HarryPehkonen/xiao-ac-dimmer/BOM.md

# BOM — one board

Generated from the schematic, not typed from memory:

```bash
kicad-cli sch export bom --fields "Reference,Value,Footprint" \
  -o bom.csv xiao-ac-dimmer.kicad_sch
```

20 parts. `bom.csv` is the source of truth for values and footprints; this file
adds the part of the BOM a generator cannot know: **where to buy it, and what it
costs to get it here.**

## The sourcing rule

> **Consolidate to the fewest orders first. Origin is a tiebreaker on price, not
> an absolute.** A US-origin part that saves a shipment wins; a $6 saving that
> creates a second shipment loses.

Two constraints in tension, both Harri's:

1. **Non-US origin preferred** — US-origin parts carry tariff and political
   cost. DigiKey's Canadian presence is welcome as a *channel* (one shipment,
   CAD pricing, traceability), not as a statement about origin.
2. **Shipping is per-supplier and it is not small.** DigiKey CA: **free delivery
   at $100 CAD or more; about $15 CAD below that** (their delivery page states
   the $100 threshold; the sub-$100 charge has been reported rising to $15).

So a 20-line BOM can carry more shipping than parts. Two ways out: **pad the
order over $100** (spares of the passives are nearly free, and more boards are
coming), or **accept the charge once** rather than paying it several times.

## Where each part comes from

| Source | Parts |
| --- | --- |
| **DigiKey CA** (one order) | `C1` 470µF 16V · `C2` 100nF · `CS1` 100nF 400V · `D5` SS14 · `F1` 5×20mm fuseholder clip + 3.15A fuse · `MOV1` S14K150 · `Q1` BTA16-600B · `U1` H11AA1 · `U2` MOC3021M · `R1`,`R2` 47k · `R3` 220 · `R4` 1k · `R5` 10k · `RS1` 100 · `J1`,`J2` 1×07 pin sockets · `J3`,`J4` 5.08mm 2-pin terminal blocks |
| **AliExpress** | `PS1` HLK-PM01 5V 3W (about $1.79 CAD) |
| **Check the drawer first** | `U2` MOC3021M · `U1` H11AA1 · all resistors · 100nF / 470µF caps |

**Check the drawer first, seriously.** If the optos and the passives are already
in stock, the DigiKey order collapses to the awkward parts — terminals, fuse
holder, MOV, sockets — perhaps $25 of goods carrying $15 of shipping. That is
exactly the case where padding the order beats paying the charge.

### Why not the DigiKey alternative for PS1

Mean Well IRM-03-5 (`1866-3020-ND`) is the electrical equivalent (5V 3W 0.6A,
85–305 VAC in) and DigiKey stocks it, but: it is a **US-brand part at about
$8.17 CAD** after tariff, against $1.79; the swap costs **footprint change plus
rerouting PS1's pads and re-checking the 3mm barrier**; and the HLK-PM01's
footprint is already in the design. DigiKey publishes no Hi-Link parts at all —
their own TechForum cross-reference thread says they "cannot duplicate the
footprint shown on the HLK-PM01 data sheet" and names Recom RAC03-05SK
(`945-3441-ND`) as an electrically-correct substitute *with the wrong pin
layout*. KiCad has no RAC03 footprint; it does have the IRM-03 one.

**HLK-PM01 input range: 100–240 VAC, universal** — the manufacturer's own page
says "Rated input voltage 100-240Vac", and it is tested at 120 V and 230 V.
Listings titled "220V to 5V" are using the Chinese-market convention; it works
on North American 120 V mains. Max input current <0.2A.

### One spec to tighten

`CS1` is currently `100nF 400V`. For snubber duty across a mains triac, specify
the **part class**: an X2 or mains-duty film capacitor rated **250 VAC or
better**. "400 V" is a DC rating; it is not the same claim.

## The module (not on the PCB BOM)

The board has no MCU on it — it mounts a **Seeed Studio XIAO ESP32C3** in two 2×7
sockets (`J1`/`J2`), so the module never appears in the generated BOM. Order it
separately.

- **Part / SKU: `113991054`** (Seeed Studio; listed by Mouser under that same
  manufacturer number, category "Multiprotocol Modules").
- **Seeed direct** — seeedstudio.com, USD **$4.99**, in stock, sold 1pcs / 3pcs.
  Has China, US and German warehouses; **no Canadian warehouse**, so a Canadian
  order ships from China or the US.
- **Mouser Canada** (mouser.ca) lists the same number for CAD pricing.
- **DigiKey CA** returns 5 results for "XIAO ESP32C3" and hosts this part's
  datasheet, but its part number and stock **were not verified** — its result
  list would not render into text for me. Confirm on the page rather than
  trusting a `-ND` number written here.

**Order the Pre-Soldered variant.** `J1`/`J2` are female sockets, so the module
needs pins on it; Un-Soldered means hand-soldering 14 pins.

**Get the ESP32C3, not the ESP32S3 or C6.** They share the footprint and would
plug in, but the pin↔GPIO mapping differs, and this design assigns `D1`=GPIO3
(triac trigger) and `D2`=GPIO4 (zero-cross input). A different variant fits the
board and silently fires the wrong pins.

Two practical notes: 2.4 GHz does not pass through a metal enclosure, so use a
non-metallic box (or run the module's U.FL connector to an external antenna) —
and keep the antenna end away from `PS1` and the mains wiring. Flashing is over
USB-C; the `SS14` (`D5`) is there so USB 5 V and the PSU's 5 V can coexist
without one back-feeding the other.

## Mechanical — mounting

Four M3 clearance holes, one per corner, **5mm inset** from each board edge.
They are in the generated board, not a drawing note:

- **3.2mm drill**, non-plated (`MountingHole:MountingHole_3.2mm_M3`): no pad, no
  annular ring, connected to no net, so nothing is bonded and no copper sits
  under the screw head. They carry `exclude_from_bom` and
  `exclude_from_pos_files`, so they do not show up as parts to place.
- **6mm copper keepout** per hole — a 6mm-*diameter* copper-free disc, i.e. no
  track, via or pad edge within 3mm of the hole centre. A socket-head M3 screw
  is 5.5mm across, so the disc covers the head with a little margin. (Reading
  the spec the other way, a 6mm *radius*, puts the disc off the board: a 5mm
  inset hole would leave the outline.)
- **Nylon standoffs, not metal.** This is a two-wire appliance with no earth
  conductor, so there is nothing for a metal standoff or a metal enclosure to be
  safely bonded to. Plastic standoffs and a plastic box avoid the question
  entirely.
- Where it lives: `tools/gen_pcb.py` places them (`MOUNTING`, `MOUNT_INSET`,
  `MOUNT_DRILL`, `MOUNT_KEEPOUT`), `tools/route.py` enforces the keepout on both
  layers, and `tools/check_board.py` re-measures the finished board — inset,
  drill, NPTH, isolation and copper clearance — so a later re-route cannot
  quietly put copper back under a screw.
- The corner keepouts changed the corridors, and the holes' courtyards own the
  outer 3.45mm of each corner, so the packing strips start 9mm from the top
  instead of hugging the edge. The router still gets **16/16 nets** with 0 DRC
  errors and 0 warnings.

## Mechanical — board outline

**150 × 57mm (85.5cm²)**, down from 150 × 95mm (142.5cm²). The 20 parts span
41.9mm top to bottom (y 9 → 50.9mm), so the old 95mm left a **54mm dead band
along the bottom edge** — a third of the board. The height had been raised from
90mm to 95mm *while the router was failing*, and it stayed after the router was
fixed, because nothing measures the outline: it is an input to the pipeline, not
a result.

The height is now sized to the packed parts instead of chosen first (see
`BOARD_H` in `tools/gen_pcb.py`). 57mm keeps the 9mm the top mounting holes need
above the first row and leaves 6.1mm below the last — **15% spare on the bottom
side**, inside the 10-20% tolerance. The mounting holes are unaffected: still
5mm inset, 3.2mm NPTH, 6mm copper-free disc, which `check_board.py` re-measures
on the finished board at the new height.

## Mechanical — thermal

`Q1` (BTA16-600B) is the only real heat source. Its dissipation is the on-state
drop times load current, roughly 1.0–1.2 V at 1 A:

| Load | Dissipation | Verdict |
| --- | --- | --- |
| 60 W lamp (~0.5 A) | ~0.6 W | No heatsink. ~35 °C rise on a TO-220 in free air |
| 100 W lamp (~0.85 A) | ~1.0 W | Borderline. ~60 °C rise; a small clip-on heatsink is cheap insurance |
| Board ceiling, 3.15 A | ~3.5–4 W | **Real heatsink required.** ~5 °C/W, tab-mounted |

Notes that matter more than the table:

- **BTA (isolated tab), not BTB.** The `A` part's tab is electrically isolated,
  so a heatsink needs no insulating pad. Keep the heatsink **floating** —
  connected to no net.
- In an **enclosed box** the ambient is 40–50 °C, not 25 °C. Derate accordingly;
  the numbers above assume free air.
- `PS1`, the snubber, `MOV1` and the fuse are thermally irrelevant at this
  power level.
- Ventilation in the box is worth more than a bigger heatsink.
