HarryPehkonen/xiao-ac-dimmer/sim/results.txt

delay(ms) theta(deg)  sim Vrms   theory    err% watts/240R
      0.2        4.3    120.20   120.20    0.00       60.2
      0.5       10.8    120.12   120.12    0.00       60.1
      1.0       21.6    119.54   119.54    0.00       59.5
      1.5       32.4    118.02   118.03    0.00       58.0
      2.0       43.2    115.22   115.23    0.00       55.3
      2.5       54.0    110.91   110.92    0.00       51.3
      3.0       64.8    104.97   104.98    0.00       45.9
      4.0       86.4     88.33    88.33    0.00       32.5
      5.0      108.0     66.54    66.54    0.00       18.4
      6.0      129.6     42.27    42.27    0.00        7.4

worst disagreement vs closed form: 0.00%  (load 240.0 ohm resistive)
