HarryPehkonen/xiao-ac-dimmer/xiao-ac-dimmer.kicad_pcb

## KiCad design xiao-ac-dimmer.kicad_pcb (2026-11-03)

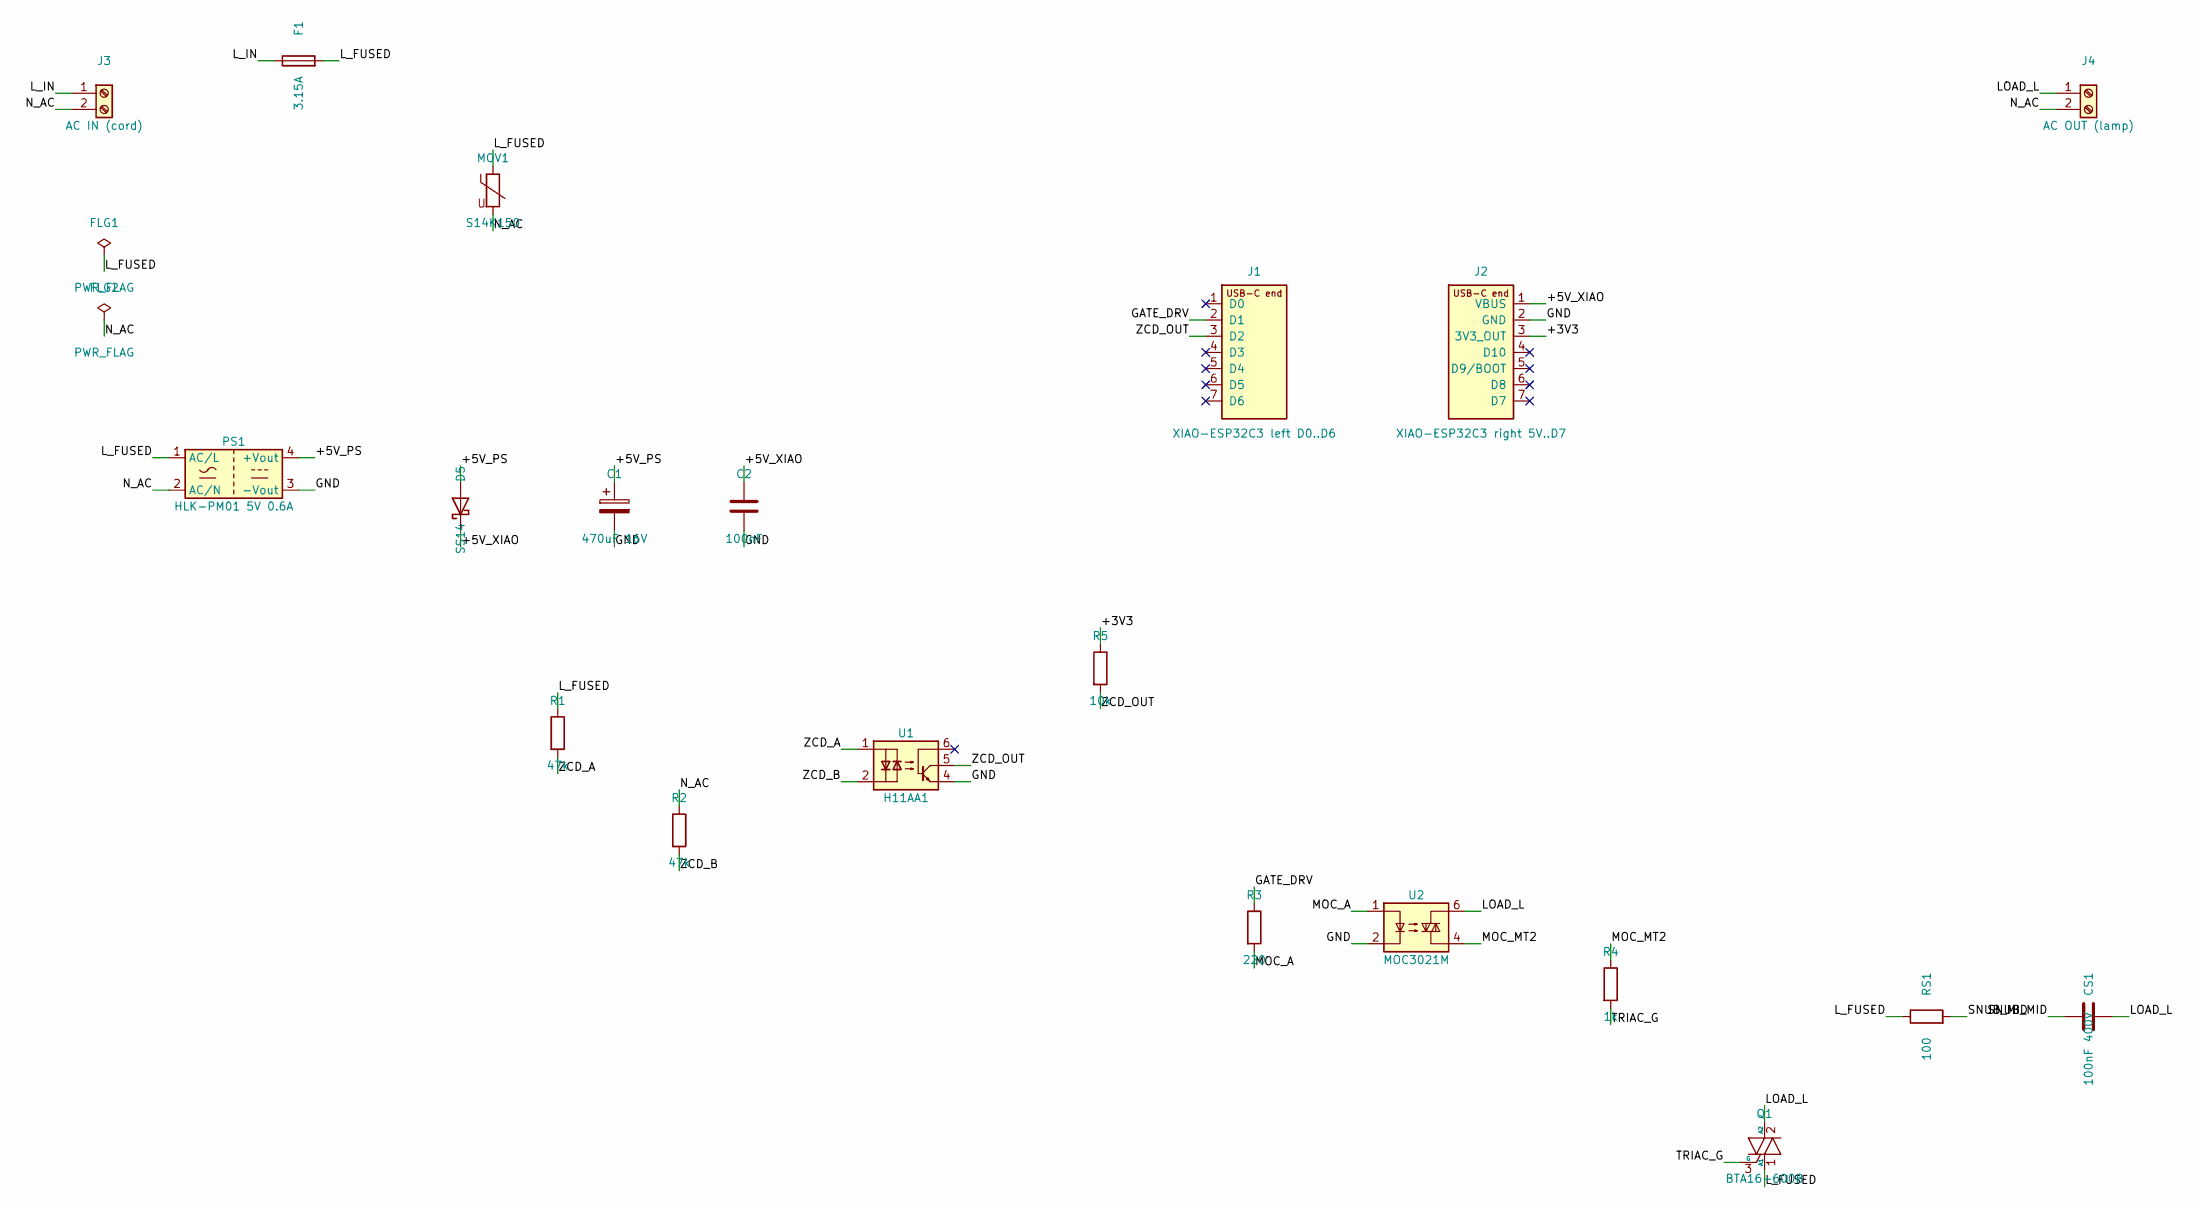
[picture p1: schematic xiao-ac-dimmer.kicad_sch, XIAO AC dimmer - 1 channel, inline cord]

Parts:
C1: 470uF 16V; CP_Radial_D8.0mm_P3.50mm
C2: 100nF; C_Disc_D5.0mm_W2.5mm_P5.00mm
CS1: 100nF 400V; C_Rect_L7.0mm_W2.0mm_P5.00mm
D5: SS14; D_DO-41_SOD81_P10.16mm_Horizontal
F1: 3.15A; Fuseholder_Clip-5x20mm_Keystone_3512P_Inline_P23.62x7.27mm_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
FLG1, FLG2: PWR_FLAG
J1: XIAO-ESP32C3 left D0..D6; PinSocket_1x07_P2.54mm_Vertical
J2: XIAO-ESP32C3 right 5V..D7; PinSocket_1x07_P2.54mm_Vertical
J3: AC IN (cord); TerminalBlock_Phoenix_MKDS-1,5-2-5.08_1x02_P5.08mm_Horizont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
J4: AC OUT (lamp); TerminalBlock_Phoenix_MKDS-1,5-2-5.08_1x02_P5.08mm_Horizont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
MOV1: S14K150; RV_Disc_D12mm_W4.5mm_P7.5mm
PS1: HLK-PM01 5V 0.6A; Converter_ACDC_Hi-Link_HLK-PMxx
Q1: BTA16-600B; TO-220-3_Vertical
R1, R2: 47k; R_Axial_DIN0207_L6.3mm_D2.5mm_P10.16mm_Horizontal
R3: 220; R_Axial_DIN0207_L6.3mm_D2.5mm_P10.16mm_Horizontal
R4: 1k; R_Axial_DIN0207_L6.3mm_D2.5mm_P10.16mm_Horizontal
R5: 10k; R_Axial_DIN0207_L6.3mm_D2.5mm_P10.16mm_Horizontal
RS1: 100; R_Axial_DIN0207_L6.3mm_D2.5mm_P10.16mm_Horizontal
U1: H11AA1; DIP-6_W7.62mm
U2: MOC3021M; DIP-6_W7.62mm

Connections:
+3V3: J2.3 (3V3_OUT), R5.1
+5V_PS: C1.1, D5.2 (A), PS1.4 (+Vout)
+5V_XIAO: C2.1, D5.1 (K), J2.1 (VBUS)
GATE_DRV: J1.2 (D1), R3.1
GND: C1.2, C2.2, J2.2 (GND), PS1.3 (-Vout), U1.4, U2.2
LOAD_L: CS1.2, J4.1, Q1.2 (A2), U2.6
L_FUSED: F1.2, FLG1.1, MOV1.1, PS1.1 (AC/L), Q1.1 (A1), R1.1, RS1.1
L_IN: F1.1, J3.1
MOC_A: R3.2, U2.1
MOC_MT2: R4.1, U2.4
N_AC: FLG2.1, J3.2, J4.2, MOV1.2, PS1.2 (AC/N), R2.1
SNUB_MID: CS1.1, RS1.2
TRIAC_G: Q1.3 (G), R4.2
ZCD_A: R1.2, U1.1
ZCD_B: R2.2, U1.2
ZCD_OUT: J1.3 (D2), R5.2, U1.5

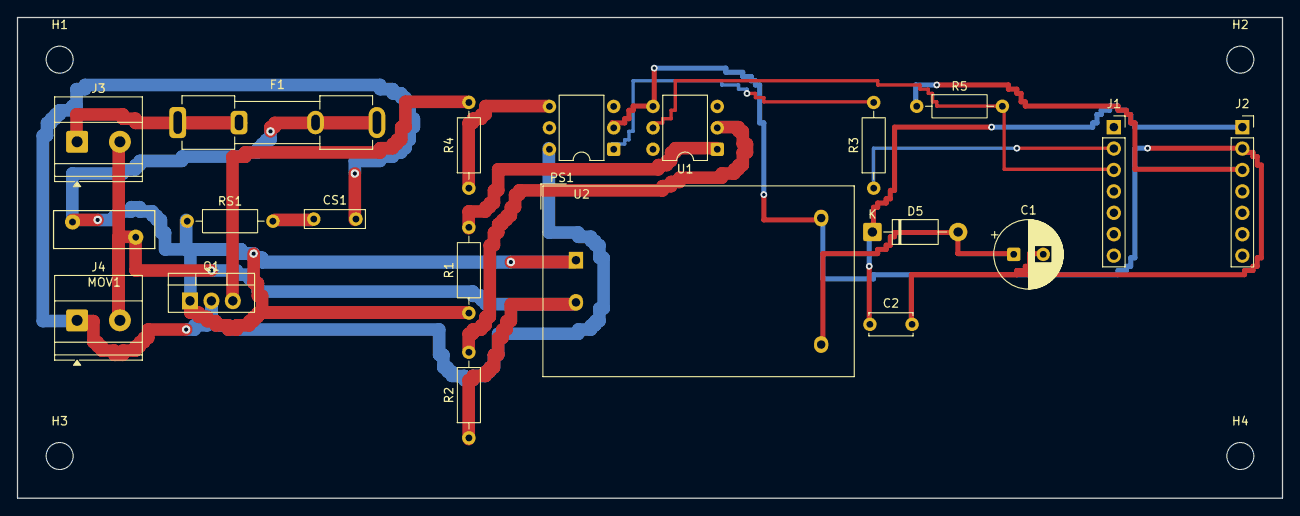
[picture p2: board xiao-ac-dimmer.kicad_pcb from above]

Board: 2 copper layers, 150.0 x 57.0 mm, 24 parts (0 on the bottom side), 16 nets.

Other parts of the board:
H1, H2, H3, H4: MountingHole_3.2mm_M3
