HarryPehkonen/xiao-ac-dimmer/(commit log)

2026-11-02 XIAO AC dimmer: generated schematic, netlist gate, ERC clean
    - tools/gen_sch.py builds xiao-ac-dimmer.kicad_sch from a parts/nets table
    (labelled stubs; no hand-drawn wires to drift out of sync)
    - tools/kicadlib.py: s-expression reader, symbol flattening for (extends)
    - tools/check_netlist.py gates the exported netlist against the intent --
    it caught a rotated-symbol pin swap that would have fitted D5 backwards
    - tools/ci.sh: regenerate check, netlist gate, ERC
    - sim/: leading-edge dimmer RMS vs closed form, 0.00% worst case
    - 1 channel, mains-fed HLK-PM01, MOC3021 + BTA16 phase control, H11AA1 ZCD
    - Unlicense
    [xiao-ac-dimmer.kicad_sch]
2026-11-02 gate: compare the schematic hash before regenerating
    The old check regenerated first, so it could never detect a stale committed
    schematic. Proven both ways: appending junk to the .kicad_sch now fails the
    gate, regenerating restores it.
2026-11-02 pcb: generated board, maze router, DRC barrier rule (3 nets unrouted)
    Nets come from the schematic netlist export so board and schematic cannot
    disagree. Placement is a zone packer (no courtyard overlaps by construction);
    routing is an A* maze router over a 0.5 mm grid with two occupancy grids so
    the 3 mm mains barrier does not fence the mains zone off from itself.
    The barrier is a kicad_dru rule, not a drawing note.
    DRC: no shorts, no clearance errors, 3 unconnected nets (TRIAC_G, MOC_MT2,
    MOC_A) and 4 hole_to_hole warnings from vias near pads. check_board.py is
    deliberately not wired into tools/ci.sh while it fails. See docs/PCB-NOTES.md.
    [xiao-ac-dimmer.kicad_pcb]
2026-11-02 pcb: 14/16 nets routed, DRC clean of shorts and clearance errors
    Diagnosis-driven routing fixes, each from a measured failure:
    - merge collinear grid steps: 2161 -> 410 segments
    - zone repack with the mains-side resistors in their own barrier strip; Q1
    last so its gate sits beside R4; U2 first so its logic pins face the logic
    cluster; wider board (150x95) for the barrier corridor
    - TRIAC_G and MOC_MT2 are mains-referenced (hot side of the opto) and were
    classed as logic, which made them demand 3 mm from the mains zone they live
    in; unroutable by construction. Fixed in the router and the kicad_dru rule.
    - route 2-pad nets before multi-pad power nets; escape spoke per pad
    perpendicul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
    [xiao-ac-dimmer.kicad_pcb]
2026-11-02 docs: ninny brief — red test first, explore in /tmp, run the acceptance command after every write
    Lessons from the first ninny run (see harrisbook posts 35 and 37): the
    delegate made nine writes and never ran the suite once, and left seven
    throwaway prototypes in tmp_diag/.
2026-11-03 BOM.md: sourcing rule, DigiKey CA shipping thresholds, mounting holes + thermal plan
    - Consolidation rule: fewest orders first, origin as a price tiebreaker.
    - DigiKey CA: free delivery at $100 CAD, ~$15 below it (their delivery page).
    - Why PS1 stays an HLK-PM01 from AliExpress, and why the IRM-03-5 swap is dead.
    - HLK-PM01 is universal input 100-240VAC despite '220V' listing titles.
    - CS1 should be specified as an X2/mains-duty film cap, 250VAC or better.
    - Mounting: no holes yet; 4x M3, 5mm inset, isolated pads, nylon standoffs.
    - Thermal: BTA16 dissipation table; no heatsink to 0.5A, real one at 3.15A.
2026-11-03 pcb: 16/16 nets routed, DRC clean of errors and warnings
    Bring the verified ninny pcb-2nets-r2 work into main: tools/route.py,
    tools/gen_pcb.py, tools/ci.sh, docs/PCB-NOTES.md, the two new test files and
    the regenerated board.
    Verified on this tree, not taken on trust: gen_pcb.py prints
    "routed 16/16 nets", check_board.py prints "0 error(s), 0 warning(s)",
    `pytest tools/tests/test_route_geometry.py` is 18 passed, and ./tools/ci.sh
    ends OK. The board carries 489 track segments and 15 vias, which is what
    docs/PCB-NOTES.md claims. The 3 mm barrier rule in xiao-ac-dimmer.kicad_dru and
    the net table are untouched.
    - route(): order nets by the static free-cell count of each net's tightest pad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
    [xiao-ac-dimmer.kicad_pcb]
2026-11-03 pcb: library nicknames, a nickname+keepout gate, and 4x M3 mounting holes
    Three changes in one regeneration pass, all of them in the generated board.
    1. Footprint library nicknames. FootprintLoad() returns the bare footprint name,
    so every footprint saved as (footprint "R_Axial_..." with no library link. The
    geometry is embedded and fab is unaffected, but "update footprint from
    library" could never work -- and that is the workflow a part swap needs.
    gen_pcb.py now sets the LIB_ID with its nickname on placement
    (load_footprint()).
    2. check_board.py grew the rules DRC has no rule for, and runs them on the saved
    board:
    - every footprint id must carry a library nickname;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
    [xiao-ac-dimmer.kicad_pcb]
2026-11-03 pcb: size the outline to the parts -- 150 x 95 -> 150 x 57 mm, 142.5 -> 85.5 cm2
    The 20 parts span 41.9 mm vertically (y 9 -> 50.9 mm) and 135.7 mm
    horizontally, so the 95 mm board was carrying a 54.3 mm band of empty
    board along the bottom edge. The height had been raised from 90 to
    95 mm while the router was failing and stayed after it was fixed,
    because nothing in the pipeline measures the outline -- it is an input,
    not a result.
    Final outline: 150 x 57 mm = 85.5 cm2 (was 150 x 95 mm = 142.5 cm2).
    9 mm above the first row (the top mounting holes' courtyard needs it),
    41.9 mm of parts, 6.1 mm below the last row: 15% spare on that side,
    inside the 10-20% tolerance rather than the 130% it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
    [xiao-ac-dimmer.kicad_pcb]
2026-11-03 pcb: correct the measured floor -- 52 mm, not 55, and nothing was rerouted
    The previous commit claimed 55 mm was the floor. That was not measured:
    52, 53 and 54 mm also route 16/16 with 0 DRC errors and 0 warnings, and
    51 mm is where it actually stops -- and it stops with an IndexError out of
    route.py's _open() (a pad's escape spoke walks off the bottom of the grid)
    rather than a "no path" report. A router robustness bug, not a design
    limit, and 6 mm below the outline that shipped.
    Also recorded: at 57 mm the router lays the same 506 copper items as at
    95 mm, compared item by item, so the resize rerouted nothing -- the board
    carries the routing that was already gated, not a new one that h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
    [gen_pcb.py]
2026-11-03 route: a cell off the grid is blocked, not an IndexError
    _open() walks a pad's opening disc and its escape spoke in cell coordinates and
    asks the grid about every cell it lands on. Grid.is_blocked() indexed the
    bytearray with whatever cell it was handed, while unblock(), block() and
    inside() all refuse a cell that is not on the grid -- so a pad within cr cells
    of an edge read past the end of the grid and raised
    IndexError: bytearray index out of range
    from inside the router, where the contract is the router's own
    "no path <ref>.<pad> -> <ref>.<pad> [diagnosis]". Found at 150 x 51 mm.
    is_blocked() now refuses an off-grid cell the way the rest of Grid already
    does. tools/tests/test_r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
2026-11-03 BOM: the module line (XIAO ESP32C3, SKU 113991054), sourcing and variant notes
2026-11-03 pcb: the XIAO socket pair is one 15.24 mm object -- and a gate that keeps it one
    J1/J2 were two independent generic 1x7 sockets 6.1 mm apart. Pitch ok, 7+7=14
    pins ok, netlist right, ERC clean, DRC clean, 16/16 routed -- and the module
    could not physically seat. The mating interface only exists in the *pair*, and
    no ERC or DRC rule looks at a pair. Assertion against the mating part's own
    numbers is the only defence, so the board now carries both the fix and the
    assertion.
    * gen_pcb.py: an XIAO table holding the module's geometry (row_sep 15.24 mm,
    pitch 2.54, 7 per row, width 17.8, usb_overhang 2.921, tail 2.794, socket
    drill 1.0, Seeed's pin drill 0.889). place_xiao() places BOTH r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
    [xiao-ac-dimmer.kicad_pcb]
2026-11-03 sch: J1/J2 get a symbol whose pins carry the module's names
    A generic Conn_01x07 says Pin_2 where the board means D1/GPIO3, so the
    schematic's answer to "which pin is the trigger?" was a comment a reviewer had
    to trust. Each row now has its own symbol -- symbols/xiao-ac.kicad_sym,
    generated from XIAO_ROWS in gen_sch.py -- with the module's own pin names
    (D0..D6 on J1, VBUS..D7 on J2), pin 1 at the USB-C end on both, 2.54 mm pitch
    and a body as long as the module.
    Not Seeed's own C3 symbol: theirs is the SMD variant, 22 pins numbered 1..14
    continuously across the columns, while this board carries the DIP socket --
    14 holes, two 1x07 footprints numbered 1..7 per row. The pin *names* are
    the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
    [xiao-ac-dimmer.kicad_pcb, xiao-ac-dimmer.kicad_sch]
2026-11-03 tests: make the renumbering case the one both boards can carry
    Swapping the right row's pins 1 and 2 moves real nets on both boards (the
    dimmer's pins 3/4 there are 3V3 and a no-connect, so only the name check fired
    on its board), which keeps the case identical to xiao-ac-ssr's copy.
    [test_pin_names.py]
2026-11-03 docs/tests: say why the pin-name cases sabotage a copy, not the committed file
2026-11-03 board: gate the committed board against the generator
    The schematic has always had a staleness gate (ci.sh regenerates it and
    compares hashes) and the board had nothing: a hand-edited
    xiao-ac-dimmer.kicad_pcb -- a track moved, a pad renumbered, the mains barrier
    narrowed a tenth of a millimetre -- can be perfectly DRC-clean, and the last
    change to this board was checked with a throwaway script that was never
    committed.
    The board file is not byte-reproducible (pcbnew stamps a fresh UUID on every
    item and KiCad writes them back in its own order), so this is not a hash
    compare: tools/check_regen.py copies tools/ to a throwaway directory,
    regenerates the schematic and the board there, and compa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
2026-11-03 docs: README names this repo's tests, and the two rules they do not break
    The gate list I copied the tests item from was xiao-ac-ssr's, whose
    test_board_gate.py also breaks the library-nickname and mounting-hole rules.
    This repo's copy never had those cases (a32a414 added the rules without them,
    3929cc5 created this file with the socket ones), so listing them here would
    have been a claim about a file I had not read. Corrected to the 16 socket
    cases plus the router-retry case, and the gap stated instead of glossed.
2026-11-03 tests: break the nickname and mounting-hole rules, and say so in the docs
    check_board.py enforces three rule families and only the socket one had a case
    in this repo: a32a414 added the library-nickname and mounting-hole rules and
    touched no test, 3929cc5 created tools/tests/test_board_gate.py with the 16
    socket cases and the router's. So "every rule, seen to fail" held for one
    family and was read, not proven, for the other two -- the missing cases lived
    in xiao-ac-ssr's copy of the same file.
    Ten cases now live here: nine ported from that copy, re-anchored to *this*
    repo's check_board.py (every string checked against the code, not assumed --
    the hole numbers coincide because the two boards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
    [test_board_gate.py]
